gokhangerdan/CCD_Cooler/README.md

# CCD_Cooler
THERMOELECTRIC COOLER DESIGN FOR CCD CAMERAS (BSc Thesis)

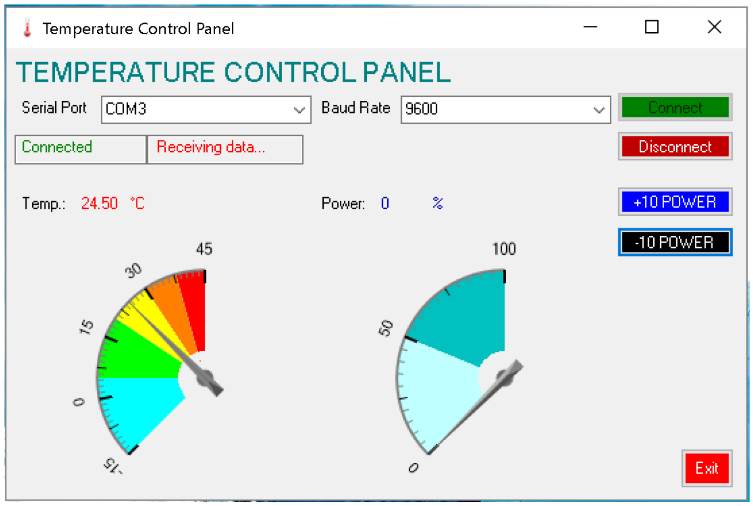
[picture p1: Screenshot from 2019-06-12 17-30-32.png]
