gokhangerdan/CCD_Cooler/serialport/serialport/Resources/6031_78b5.png

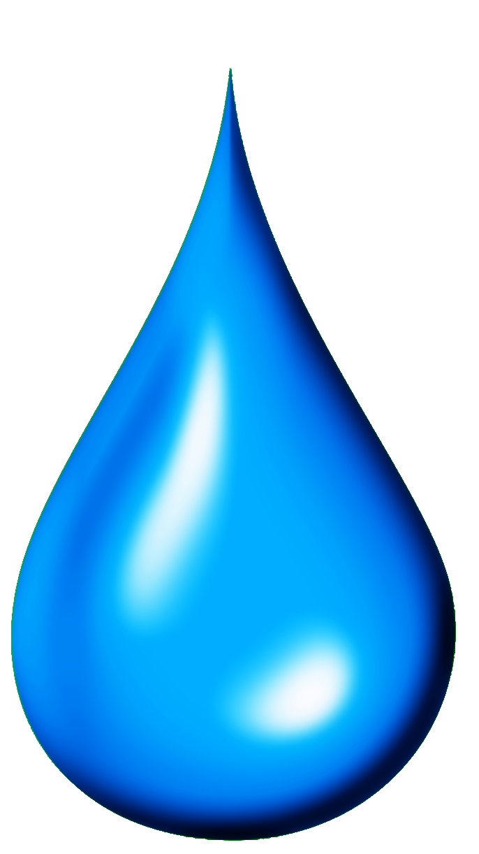
serialport/serialport/Resources/6031_78b5.png
