gokhangerdan/CCD_Cooler/serialport/serialport/Resources/11816871_1649289651952521_6621756771745635016_n.png

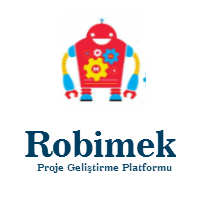
serialport/serialport/Resources/11816871_1649289651952521_6621756771745635016_n.png
